CircuitCo/BeagleBone-LCD7-RevA2/(list of files, drawings)

Other design files:
BeagleBone-LCD7-RevA2-schematic.dsn
