CircuitCo/BeagleBone-LCD7-RevA2/(commit log)

2012-10-03 rm bom a2
    [BeagleBone-LCD7-RevA2-bom.xls]
2012-10-03 upd bom a2
    [BeagleBone-LCD7-RevA2-bom.xls]
